tsukuten/pcb_led/led.kicad_pcb

## KiCad design led.kicad_pcb (2018-09-30)

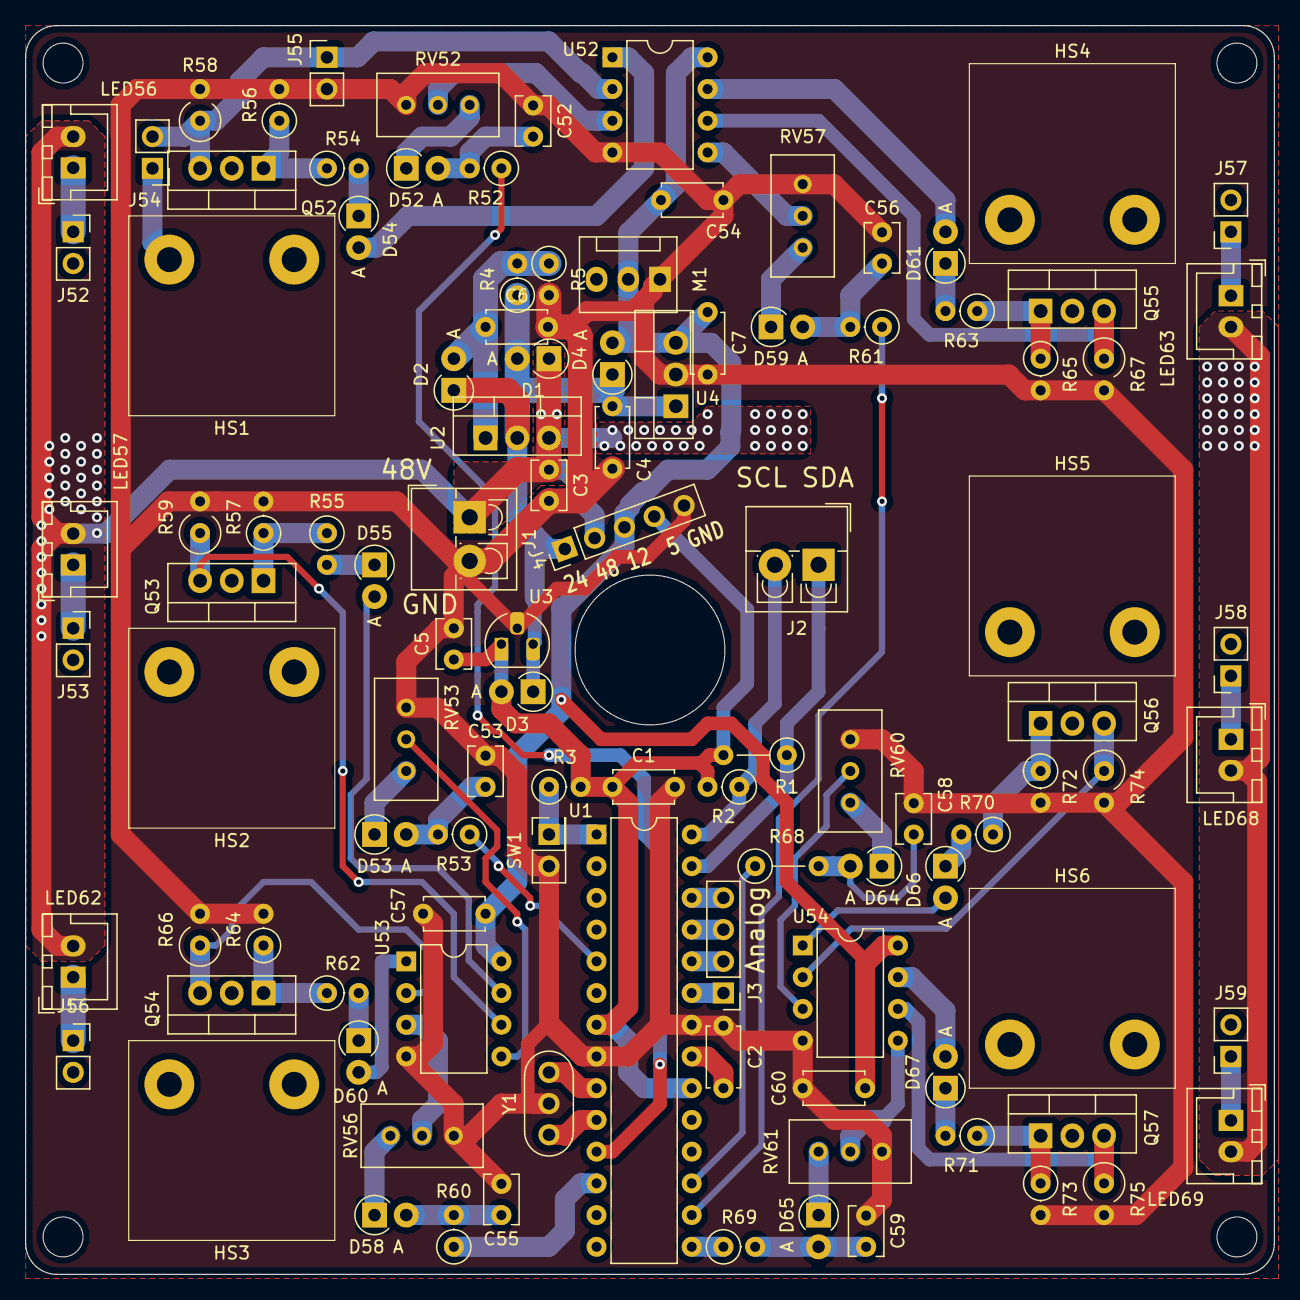
[picture p1: board led.kicad_pcb from above]

Board: 2 copper layers, 100.0 x 100.0 mm, 107 parts (0 on the bottom side), 76 nets.

Parts:
C1, C2, C4, C6, C7, C54, C57, C60: 10u; C_Disc_D4.7mm_W2.5mm_P5.00mm
C3, C5, C52, C53, C55, C56, C58, C59: 1u; C_Disc_D3.8mm_W2.6mm_P2.50mm
D1, D2, D3, D4: 1SS178; D_T-1_P2.54mm_Vertical_AnodeUp
D52, D53, D54, D55, D58, D59, D60, D61, D64, D65, D66, D67: 1V0; D_T-1_P2.54mm_Vertical_AnodeUp
HS1: Heatsink_FET_1; 16PB017-01025
HS2: Heatsink_FET_2; 16PB017-01025
HS3: Heatsink_FET_3; 16PB017-01025
HS4: Heatsink_FET_4; 16PB017-01025
HS5: Heatsink_FET_5; 16PB017-01025
HS6: Heatsink_FET_6; 16PB017-01025
J1: Slip_ring_48V; TerminalBlock_4Ucon_1x02_P3.50mm_Vertical
J2: Slip_ring_I2C; TerminalBlock_4Ucon_1x02_P3.50mm_Vertical
J3: Analog_input; PinHeader_1x04_P2.54mm_Vertical
J4: Test_power; PinHeader_1x05_P2.54mm_Vertical
J52: Jump_ID_1; PinSocket_1x02_P2.54mm_Vertical
J53: Jump_ID_2; PinSocket_1x02_P2.54mm_Vertical
J54: Test_Vds; PinHeader_1x02_P2.54mm_Vertical
J55: Test_sense; PinHeader_1x02_P2.54mm_Vertical
J56: Jump_ID_3; PinSocket_1x02_P2.54mm_Vertical
J57: Jump_ID_4; PinSocket_1x02_P2.54mm_Vertical
J58: Jump_ID_5; PinSocket_1x02_P2.54mm_Vertical
J59: Jump_ID_6; PinSocket_1x02_P2.54mm_Vertical
LED56, LED57, LED62, LED63, LED68, LED69: LED; JST_XH_B02B-XH-A_1x02_P2.50mm_Vertical
M1: Fan; FanPinHeader_1x03_P2.54mm_Vertical
Q52, Q53, Q54, Q55, Q56, Q57: EKI04027; TO-220-3_Vertical
R1, R68: 10k; R_Axial_DIN0207_L6.3mm_D2.5mm_P5.08mm_Vertical
R2, R3, R52, R53, R60, R61, R69: 10k; R_Axial_DIN0207_L6.3mm_D2.5mm_P2.54mm_Vertical
R4: 200; R_Axial_DIN0207_L6.3mm_D2.5mm_P2.54mm_Vertical
R5: 3k3; R_Axial_DIN0207_L6.3mm_D2.5mm_P2.54mm_Vertical
R54, R55, R62, R63, R70, R71: 150; R_Axial_DIN0207_L6.3mm_D2.5mm_P2.54mm_Vertical
R56, R57, R64, R65, R72, R73: 47k; R_Axial_DIN0207_L6.3mm_D2.5mm_P2.54mm_Vertical
R58, R59, R66, R67, R74, R75: 1R0; R_Axial_DIN0309_L9.0mm_D3.2mm_P2.54mm_Vertical
RV52, RV53, RV56, RV57, RV60, RV61: 10k; Potentiometer_Bourns_3296W_Vertical
SW1: Reset; PinSocket_2x01_P2.54mm_Vertical
U1: ATmega328P-PU; DIP-28_W7.62mm
U2: LM317_TO220; TO-220-3_Vertical
U3: LM78L05_TO92; TO-92L_HandSolder
U4: LM7812_TO220; TO-220-3_Vertical
U52, U53, U54: NJM13404; DIP-8_W7.62mm
Y1: 8MHz; Resonator-3Pin_W8.0mm_H3.5mm

Connections:
+5V: C1.1, C5.1, D3.2, J4.4, R1.2, R2.2, R3.2, U1.7, U1.20, U3.1
+12V: C7.1, C54.1, C57.1, C60.1, D4.2, J4.3, M1.2, U4.3, U52.8, U53.8, U54.8
+24V: C4.1, D1.2, D2.1, D3.1, D4.1, J4.1, R4.1, U2.2, U3.3, U4.1
+48V: C3.1, D1.1, J1.1, J4.2, LED56.2, LED57.2, LED62.2, LED63.2, LED68.2, LED69.2, U2.3
/ADC0: J3.1, U1.23
/ADC1: J3.2, U1.24
/ADC2: J3.3, U1.25
/ADC3: J3.4, U1.26
/PWM1: R69.1, U1.15
/PWM2: R61.1, U1.16
/PWM3: R68.1, U1.17
/PWM4: R53.1, U1.5
/PWM5: R52.1, U1.11
/PWM6: R60.1, U1.12
/SCL: J2.2, R2.1, U1.28
/SDA: J2.1, R1.1, U1.27
GND: C1.2, C2.2, C3.2, C4.2, C5.2, C6.2, C7.2, C52.2, C53.2, C54.2, C55.2, C56.2, C57.2, C58.2, C59.2, C60.2, J1.2, J4.5, J55.2, M1.1, R5.2, R56.2, R57.2, R58.2, R59.2, R64.2, R65.2, R66.2, R67.2, R72.2, R73.2, R74.2, R75.2, RV52.3, RV53.3, RV56.3, RV57.3, RV60.3, RV61.3, SW1.2, U1.8, U1.22, U3.2, U4.2, U52.4, U53.4, U54.4, Y1.2
unnamed: C2.1, U1.21
unnamed: C6.1, D2.2, R4.2, R5.1, U2.1
unnamed: C52.1, D52.2, R52.2
unnamed: C53.1, D53.2, R53.2
unnamed: C55.1, D58.2, R60.2
unnamed: C56.1, D59.2, R61.2
unnamed: C58.1, D64.2, R68.2
unnamed: C59.1, D65.2, R69.2
unnamed: D52.1, RV52.1
unnamed: D53.1, RV53.1
unnamed: D54.1, R54.2
unnamed: D54.2, U52.1
unnamed: D55.1, R55.2
unnamed: D55.2, U53.7
unnamed: D58.1, RV56.1
unnamed: D59.1, RV57.1
unnamed: D60.1, R62.2
unnamed: D60.2, U53.1
unnamed: D61.1, R63.2
unnamed: D61.2, U52.7
unnamed: D64.1, RV60.1
unnamed: D65.1, RV61.1
unnamed: D66.1, R70.2
unnamed: D66.2, U54.1
unnamed: D67.1, R71.2
unnamed: D67.2, U54.7
unnamed: HS1.1, J52.2, J54.1, Q52.2
unnamed: HS2.1, J53.2, Q53.2
unnamed: HS3.1, J56.2, Q54.2
unnamed: HS4.1, J57.2, Q55.2
unnamed: HS5.1, J58.2, Q56.2
unnamed: HS6.1, J59.2, Q57.2
unnamed: J52.1, LED56.1
unnamed: J53.1, LED57.1
unnamed: J54.2, J55.1, Q52.3, R58.1, U52.2
unnamed: J56.1, LED62.1
unnamed: J57.1, LED63.1
unnamed: J58.1, LED68.1
unnamed: J59.1, LED69.1
unnamed: Q52.1, R54.1, R56.1
unnamed: Q53.1, R55.1, R57.1
unnamed: Q53.3, R59.1, U53.6
unnamed: Q54.1, R62.1, R64.1
unnamed: Q54.3, R66.1, U53.2
unnamed: Q55.1, R63.1, R65.1
unnamed: Q55.3, R67.1, U52.6
unnamed: Q56.1, R70.1, R72.1
unnamed: Q56.3, R74.1, U54.2
unnamed: Q57.1, R71.1, R73.1
unnamed: Q57.3, R75.1, U54.6
unnamed: R3.1, SW1.1, U1.1
unnamed: RV52.2, U52.3
unnamed: RV53.2, U53.5
unnamed: RV56.2, U53.3
unnamed: RV57.2, U52.5
unnamed: RV60.2, U54.3
unnamed: RV61.2, U54.5
unnamed: U1.9, Y1.1
unnamed: U1.10, Y1.3
