tsukuten/pcb_led/(threads)

Thread 2 (2018-09-29):

Use oval holes for terminal blocks

Terminus-IMRC, 2018-09-29:
Use oval holes for terminal blocks since we haven't bought ones yet.

Terminus-IMRC, 2018-09-29:
Akizuki sells 2.54mm-pitched ones.

Terminus-IMRC, 2018-09-30:
Drill them by yourself.

Closed 2018-09-30.
