tsukuten/pcb_led/(commit log)

2018-09-26 Add semi-completed schematic files
    [driver.sch, led.sch]
2018-09-26 schematic: Use vertical footprints for axial components
    [driver.sch, led.sch]
2018-09-26 Add an WIP PCB files
    [led.kicad_pcb]
2018-09-27 schematic: Change order of opamps
    [driver.sch]
2018-09-27 schematic: Remove redundant fans
    The PCB is too small to place many fans, so leaved only one.
    [driver.sch]
2018-09-27 schematic: Change the order of PWM pins
    [led.sch]
2018-09-29 schematic: Remove POTs on negative feedback
    Sense voltage (~0.6V) is small enough without POT.
    [driver.sch]
2018-09-29 schematic: Replace NJM4580 with NJM13404 which supports unity gain
    [driver.sch]
2018-09-29 schematic: Replace FKI10531 with EKI04027 because of heat dispassion
    [driver.sch]
2018-09-29 schematic: Use more precise POT
    [driver.sch]
2018-09-29 schematic: Change footprints and pin assignments for PCB
    [driver.sch, led.sch]
2018-09-30 schematic: Add external connector for analog inputs and power testing
    [led.sch]
2018-09-30 PCB: Complete wiring
    [led.kicad_pcb]
2018-09-30 PCB: Add fill zones of power
    [led.kicad_pcb]
2018-09-30 PCB: Move silks not to conflict with coppers
    [led.kicad_pcb]
2018-09-30 PCB: Add more silks
    [led.kicad_pcb]
