tsukuten/pcb_led/(notices)

Notices in the files:
led.kicad_pcb:
(c) 2018 Tsukuba Univ. Astronomy Club
